mizdraji/Panic-Button/Documentación/Fotos/Prototipo_V1_Frente.jpg

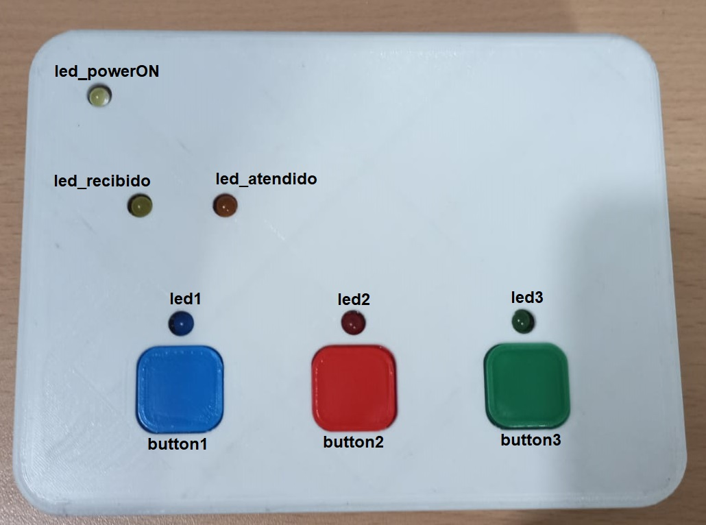
Documentación/Fotos/Prototipo_V1_Frente.jpg
