mizdraji/Panic-Button/Documentación/Fotos/RebotePulsador_4.jpg

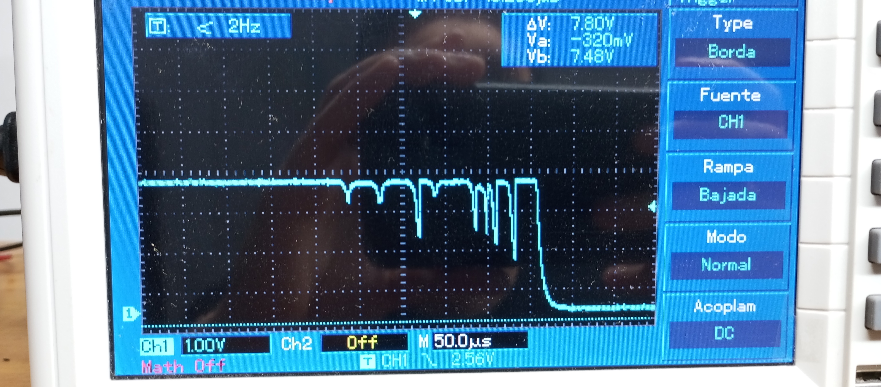
Documentación/Fotos/RebotePulsador_4.jpg
