mizdraji/Panic-Button/Documentación/Fotos/Modelo 3D Boton de panico - Lado A.jpeg

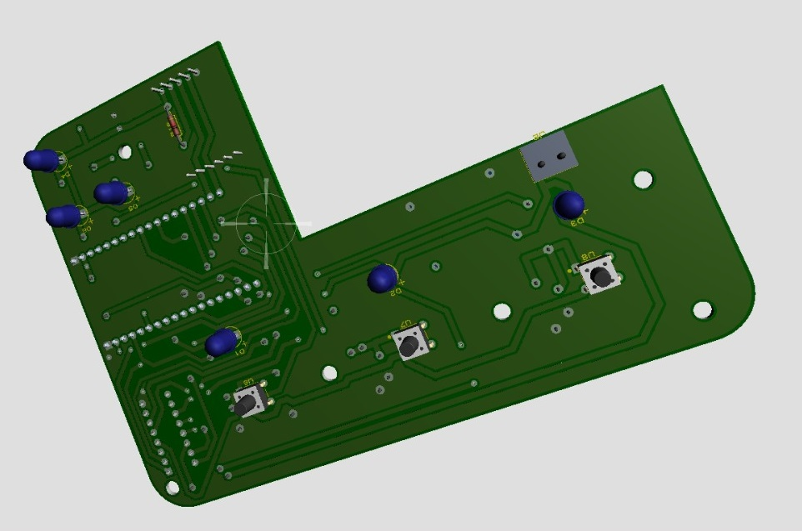
Documentación/Fotos/Modelo 3D Boton de panico - Lado A.jpeg
