mizdraji/Panic-Button/Documentación/Fotos/Modelo 3D Boton de panico - Lado B.jpeg

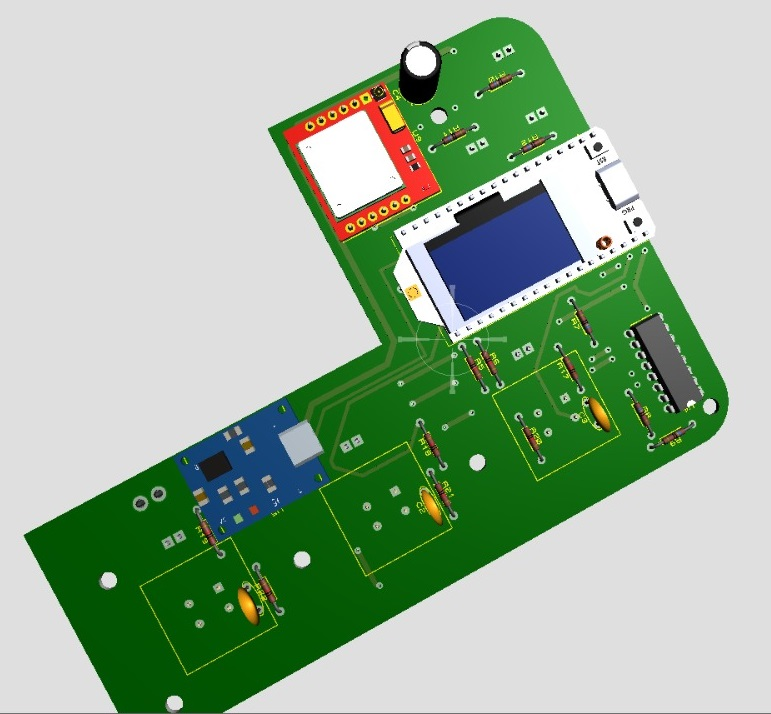
Documentación/Fotos/Modelo 3D Boton de panico - Lado B.jpeg
