mizdraji/Panic-Button/Documentación/Fotos/Prototipo_Protoboard_1.jpg

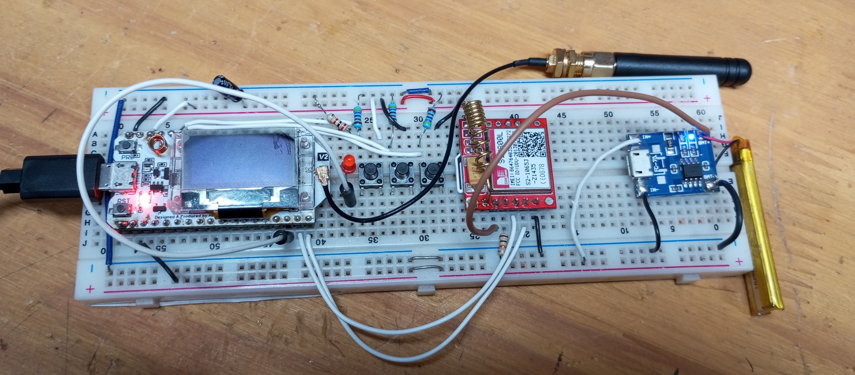
Documentación/Fotos/Prototipo_Protoboard_1.jpg
