mizdraji/Panic-Button/Documentación/Fotos/Prototipo_V1_Frente_con etiqueta.jpg

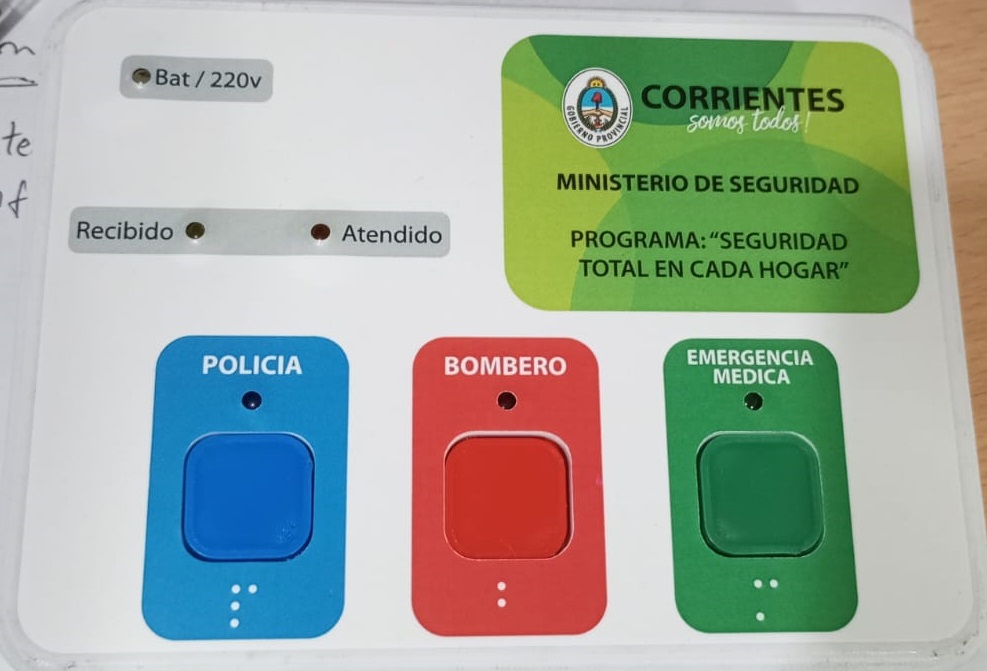
Documentación/Fotos/Prototipo_V1_Frente_con etiqueta.jpg
