mizdraji/Panic-Button/Documentación/Fotos/Prototipo_V1_Placa.jpg

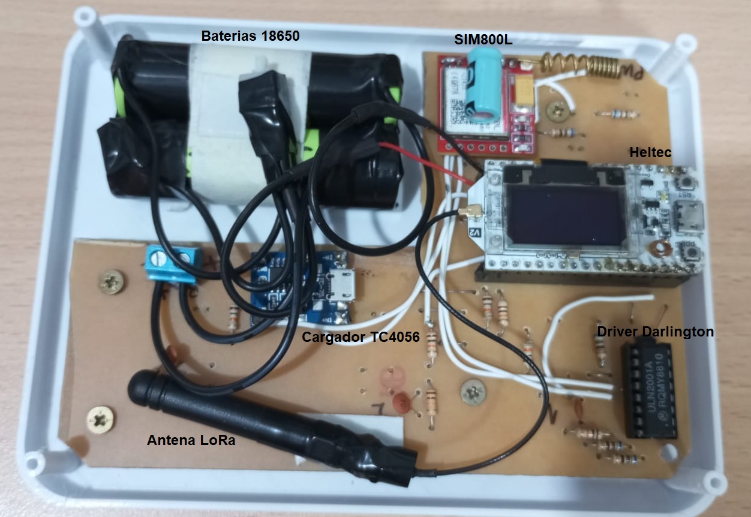
Documentación/Fotos/Prototipo_V1_Placa.jpg
