mizdraji/Panic-Button/Documentación/Fotos/RebotePulsador_1.jpg

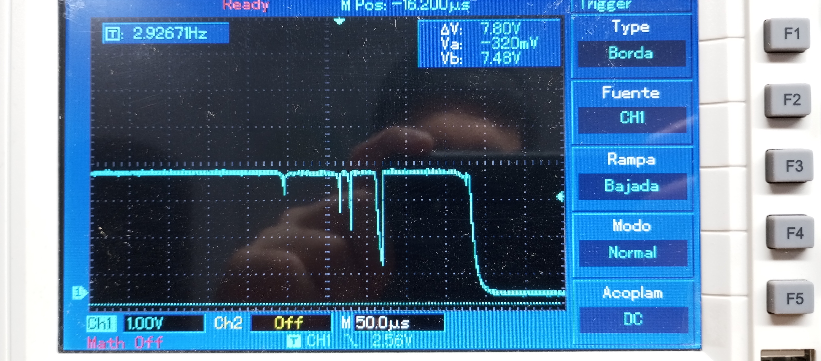
Documentación/Fotos/RebotePulsador_1.jpg
