mizdraji/Panic-Button/Documentación/Fotos/RebotePulsador_2.jpg

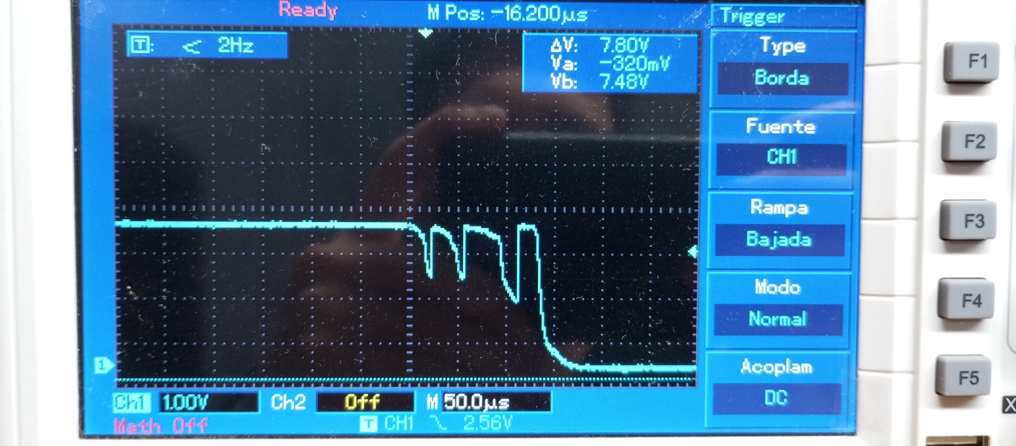
Documentación/Fotos/RebotePulsador_2.jpg
