mizdraji/Panic-Button/Documentación/Fotos/RebotePulsador_3.jpg

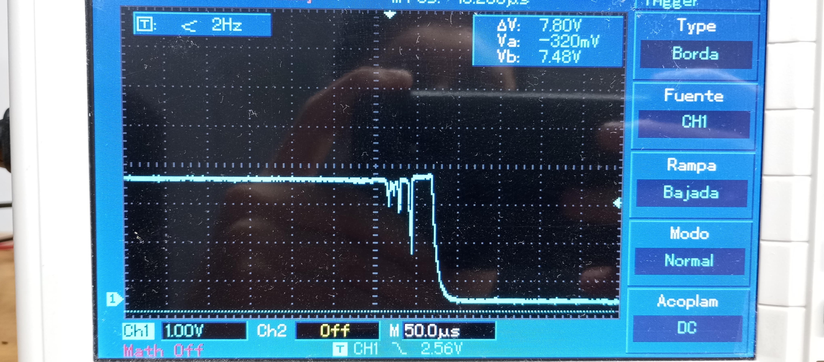
Documentación/Fotos/RebotePulsador_3.jpg
