mizdraji/Panic-Button/Documentación/Schematic/panic button - dimensiones.bmp

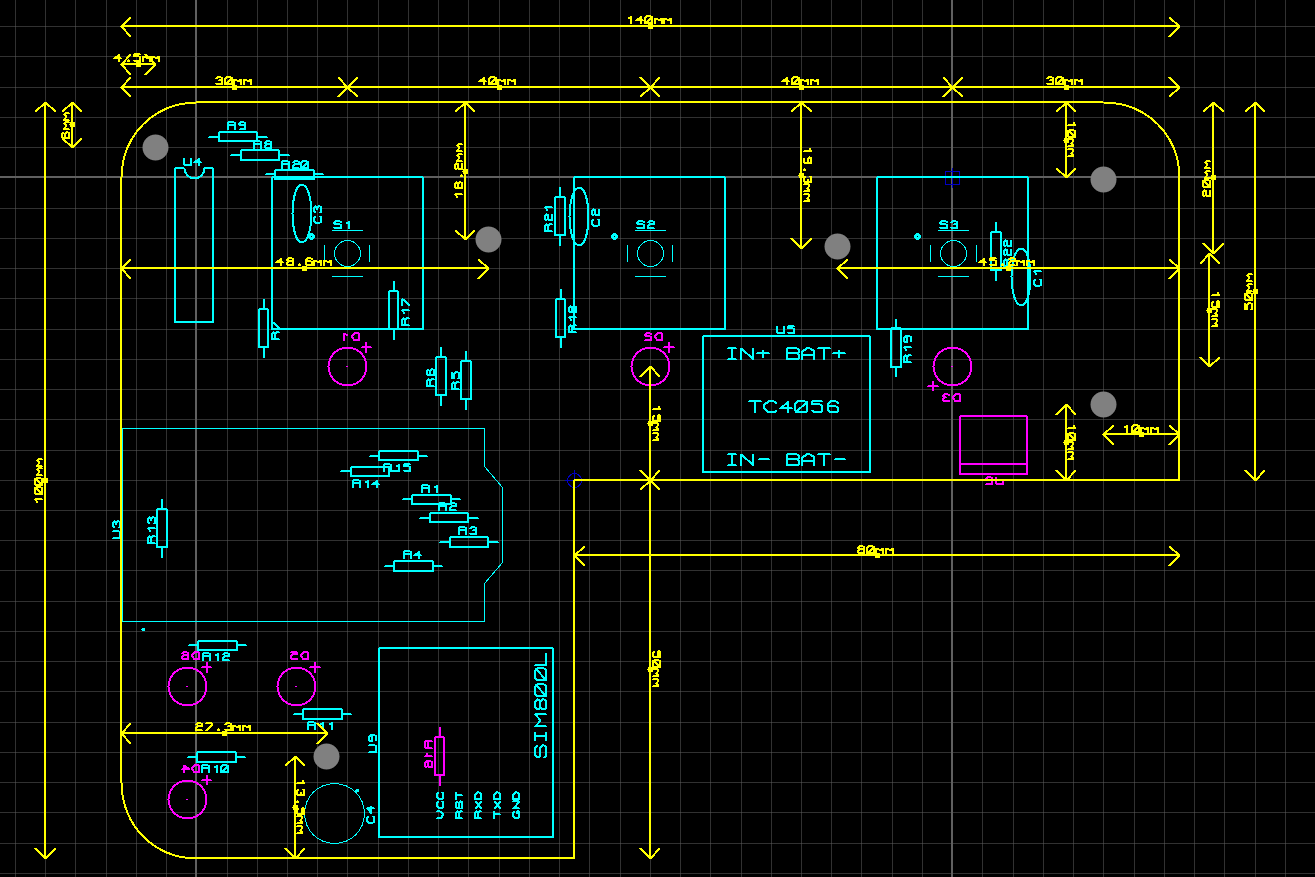
Documentación/Schematic/panic button - dimensiones.bmp
