mizdraji/Panic-Button/Solicitud de cambios para firmware.txt

// Cambios para German:

Al enviar mensajes por SMS o LoRaWAN incluir: (No necesario para la demo):
	* identificador de la aplicación. Ej: "PB" (Panic Button)
	* comando. Ej: "policia".
	* Epoch timestamp. Ej: 1726703523 segundos = 18/09/2024 20:54:08
	* numero_serie del dispositivo. Ej: "PB00001" (Puede ser generado por el servidor y enviado en la respuesta del proceso de activación de LoRaWAN).
	* versión del firmware.
	* versión del hardware.

	Ejemplo de mensaje: "PB, policia, 1726703523, PB00001, fv:1.0.0, hv:1.0.0".

Funcionamiento de idempotencia:
	Epoch timestamp se utilizará como clave de idempotencia. Esta clave asegura el procesamiento único de peticiones. 
	Al recibir una petición del mismo dispositivo, con el mismo comando e igual clave de idempotencia se responderá inmediatamente sin procesar
	nuevamente la alerta.

Respuesta:
	* identificador de la aplicación. Ej: "PB" (Panic Button)
	* comando. Ej: "policiarcv".
	* Epoch timestamp. Ej: 1726703523 (idempotencia)
	* Epoch timestamp actual (para sincronización de relojes)
	* numero_serie del dispositivo. Ej: "PB00001" (Puede ser generado por el servidor y enviado en la respuesta del proceso de activación de LoRaWAN).
	
	Ejemplo de mensaje: "PB, policiarcv, 1726703523, 1726703534, PB00001".
