mizdraji/Panic-Button/Documentación/Schematic/Boton de panico - Heltek - Schematic.PDF

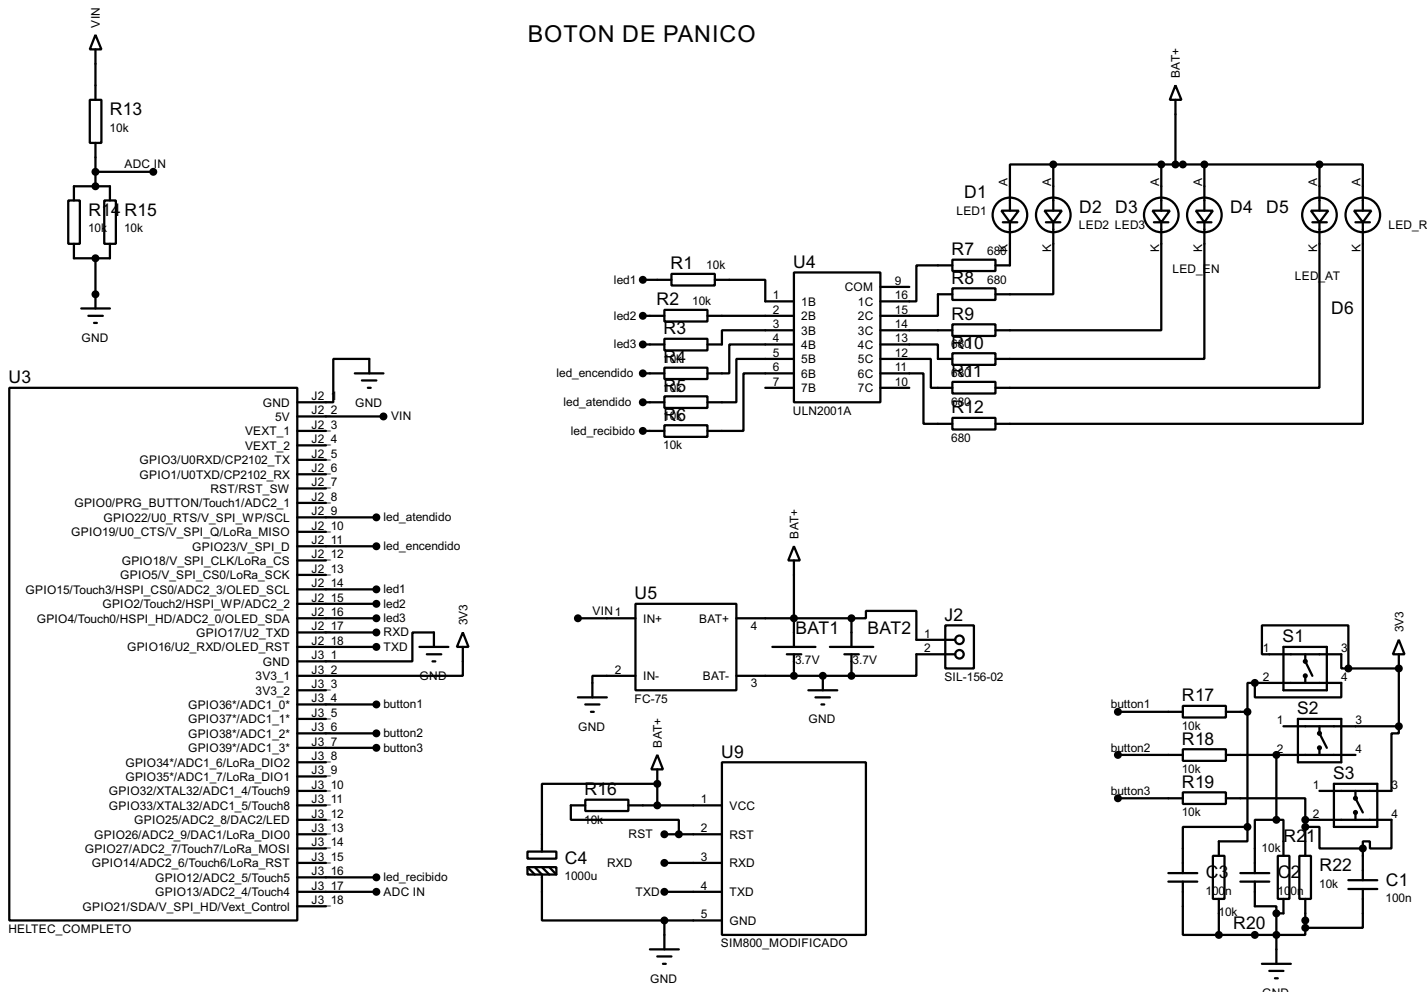
[picture p12: page 1]

4 | 13
5 | 12
6 | 11
7 | 10

J2_18 J3_1 | TXD

J3_3 GND J3_2
