mizdraji/Panic-Button/Documentación/Schematic/Boton de panico - Heltek - Dimensiones.PDF

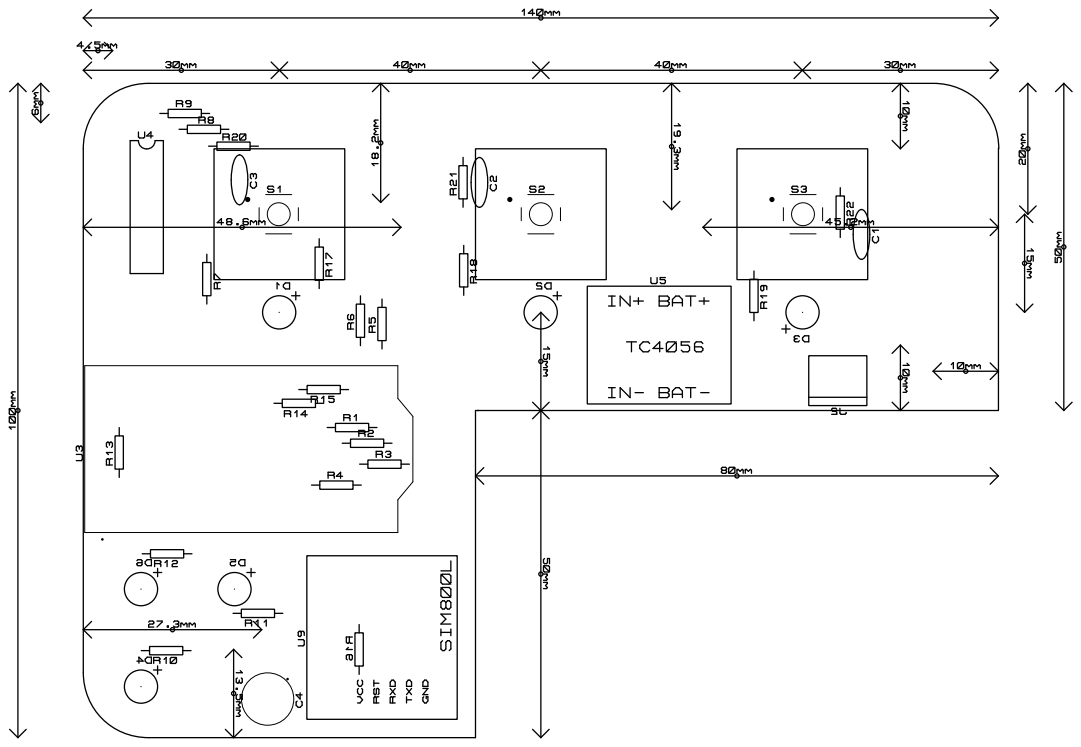
[picture p13: page 1]
