mizdraji/Panic-Button/Documentación/Schematic/BOTON PANICO PCB.pdf

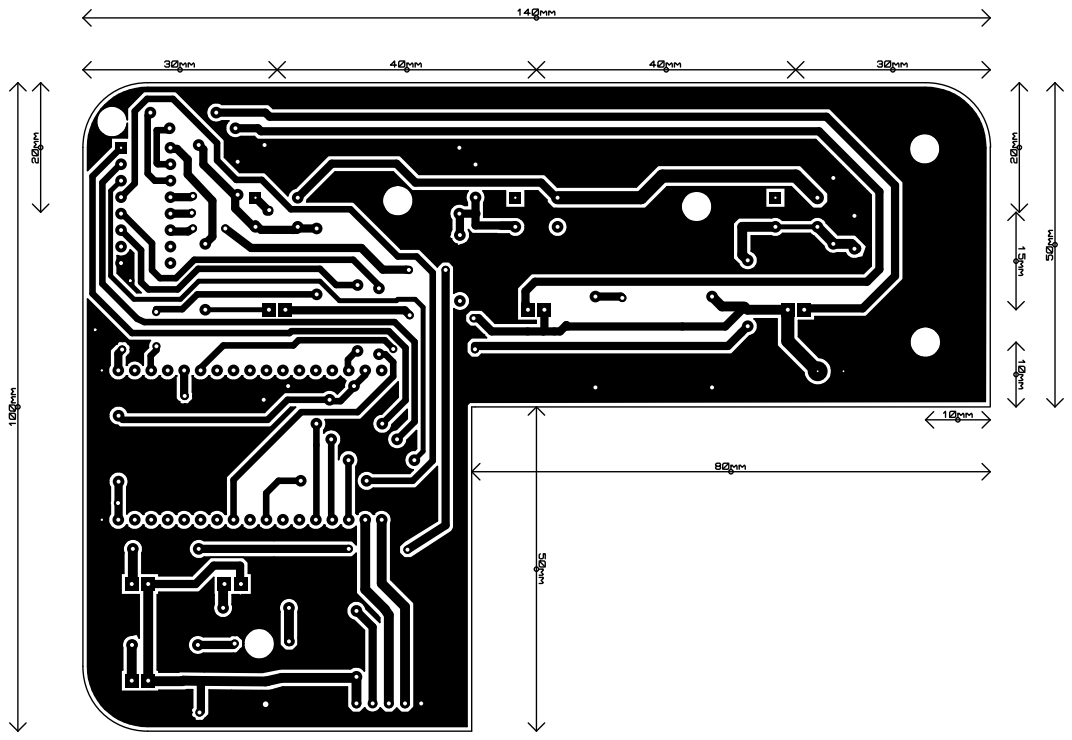
[picture p14: page 1]
