mizdraji/Panic-Button/Documentación/Schematic/Boton de panico - Heltek - PCB.PDF

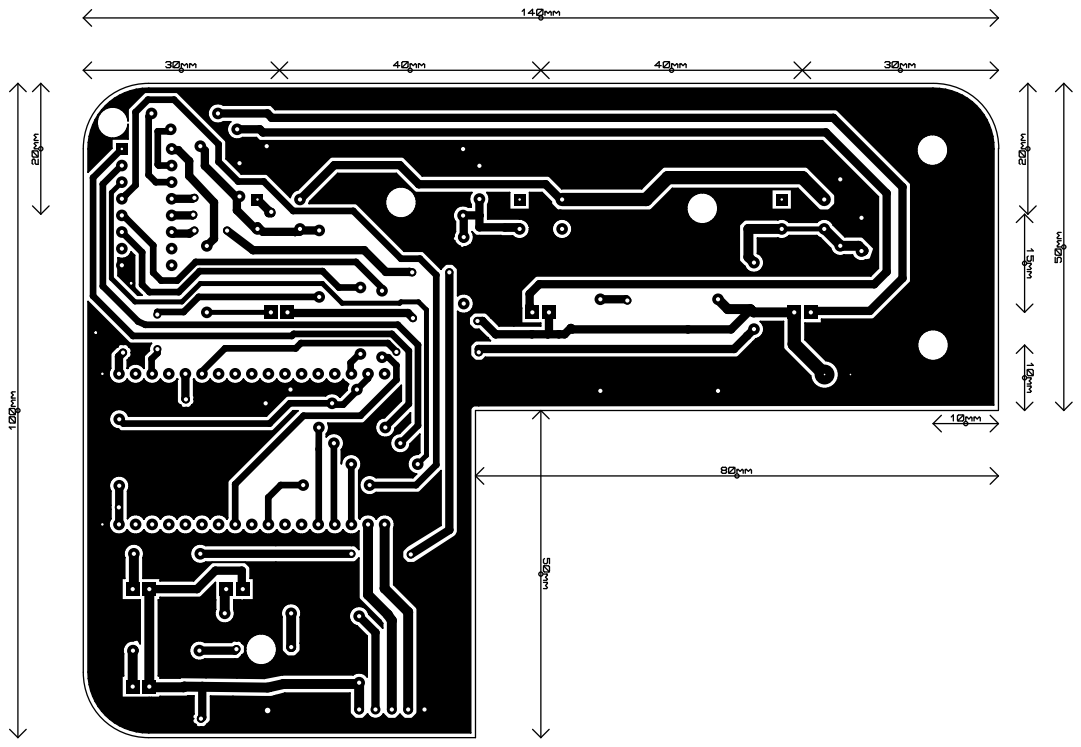
[picture p15: page 1]
