mizdraji/Panic-Button/Documentación/Prototipo web.pdf

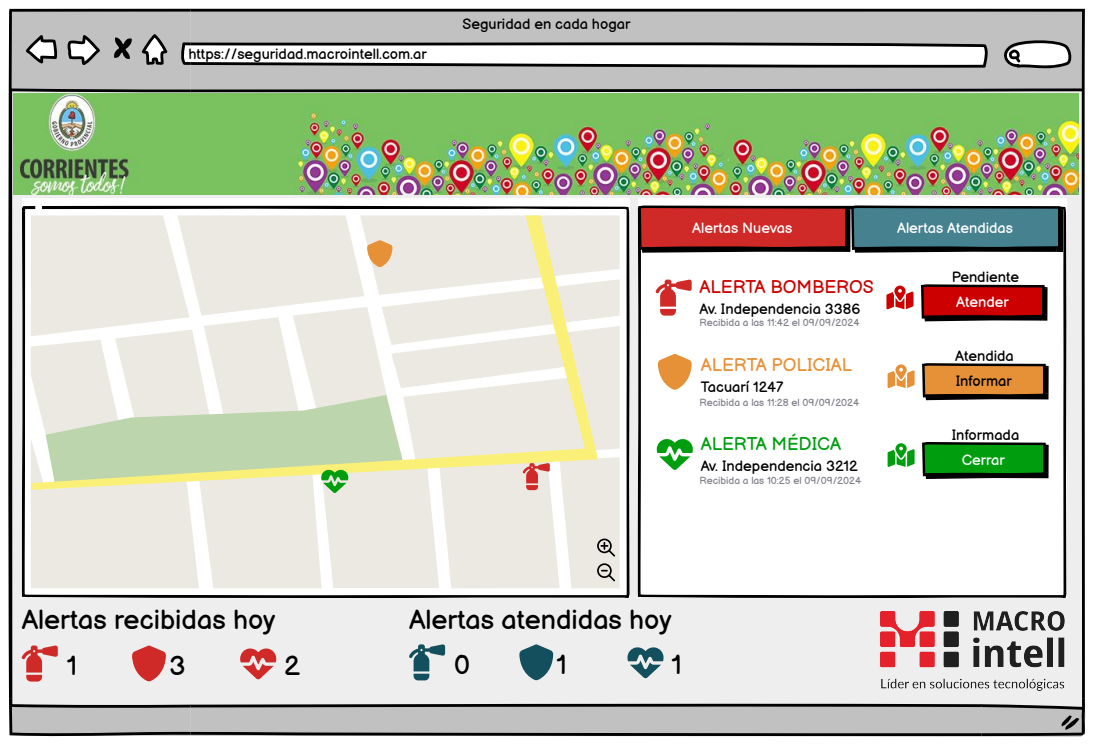
[picture p16: page 1]
Atender; Alertas Nuevas; Alertas Atendidas; Informar; Cerrar; Pendiente; Atendida; Informada; Alertas recibidas hoy; Alertas atendidas hoy

Seguridad en cada hogar

https://seguridad.macrointell.com.ar

ALERTA BOMBEROS
Av. Independencia 3386
Recibida a las 11:42 el 09/09/2024
ALERTA POLICIAL
Tacuarí 1247
Recibida a las 11:28 el 09/09/2024
ALERTA MÉDICA
Av. Independencia 3212
Recibida a las 10:25 el 09/09/2024

# NUEVA ALERTA

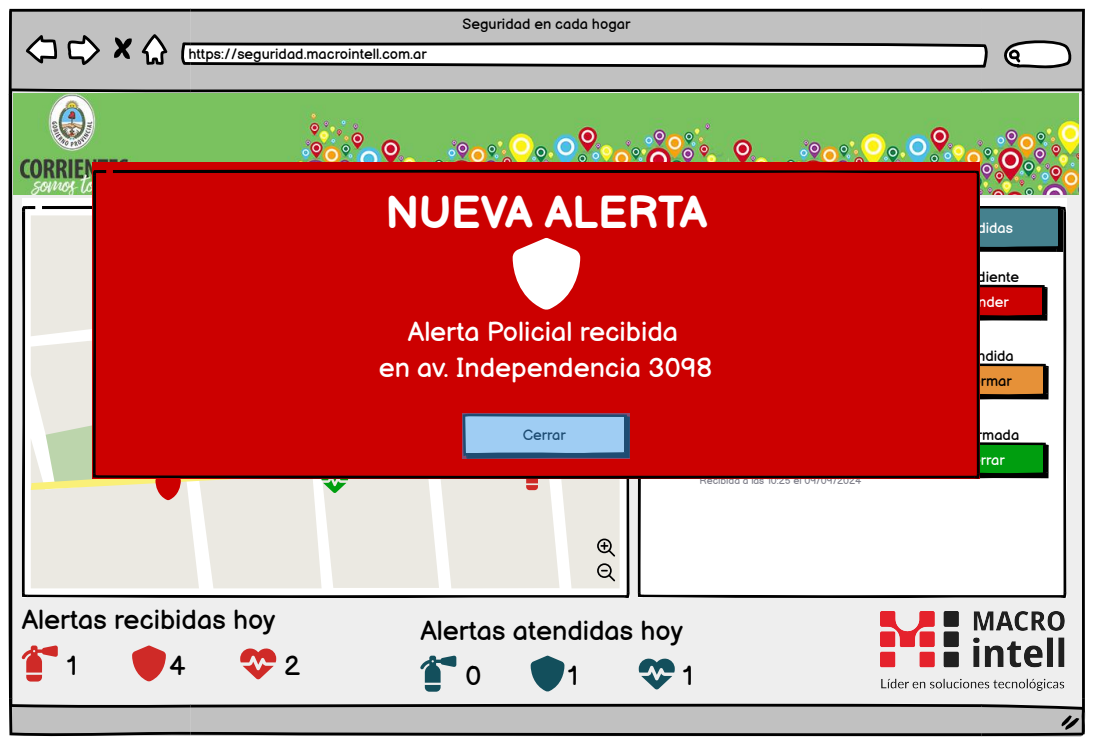
[picture p17: page 2]
Atender; Alertas Nuevas; Alertas Atendidas; Informar; Cerrar; Pendiente; Atendida; Informada

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

Alerta Policial recibida
en av. Independencia 3098

Alertas recibidas hoy

Alertas atendidas hoy

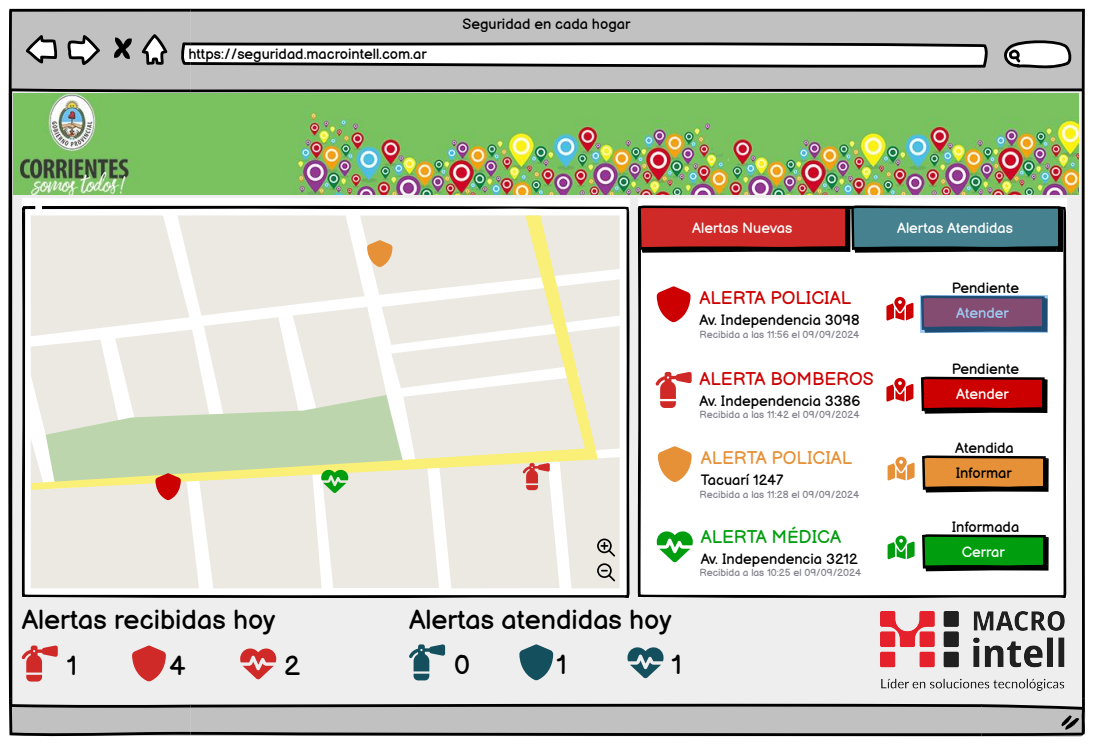
[picture p18: page 3]
Atender; Alertas Nuevas; Alertas Atendidas; Informar; Cerrar; Pendiente; Atendida; Informada

ALERTA POLICIAL
Av. Independencia 3098
Recibida a las 11:56 el 09/09/2024
ALERTA BOMBEROS
Av. Independencia 3386
Recibida a las 11:42 el 09/09/2024
Tacuarí 1247
Recibida a las 11:28 el 09/09/2024
ALERTA MÉDICA
Av. Independencia 3212
Recibida a las 10:25 el 09/09/2024

Alertas recibidas hoy

Alertas atendidas hoy

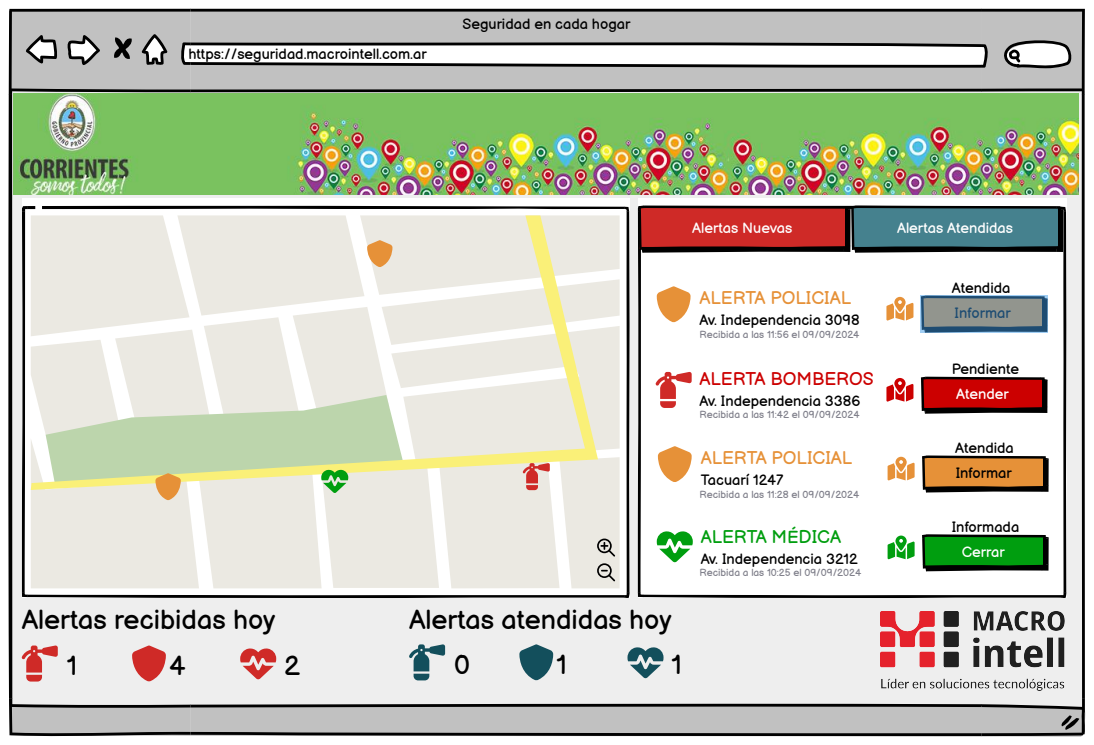
[picture p19: page 4]
Informar; Atender; Alertas Nuevas; Alertas Atendidas; Cerrar; Atendida; Pendiente; Informada

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

Alertas recibidas hoy

Alertas atendidas hoy

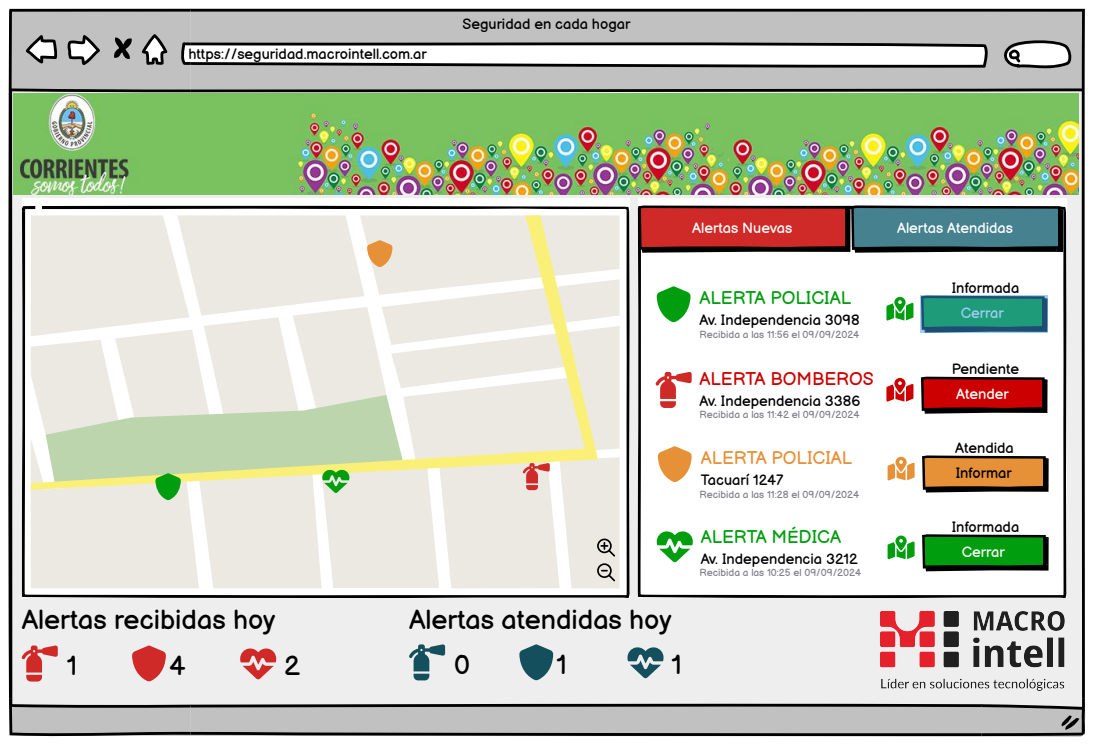
[picture p20: page 5]
Cerrar; Atender; Alertas Nuevas; Alertas Atendidas; Informar; Informada; Pendiente; Atendida

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

Alertas recibidas hoy

Alertas atendidas hoy

# Cerrar Alerta

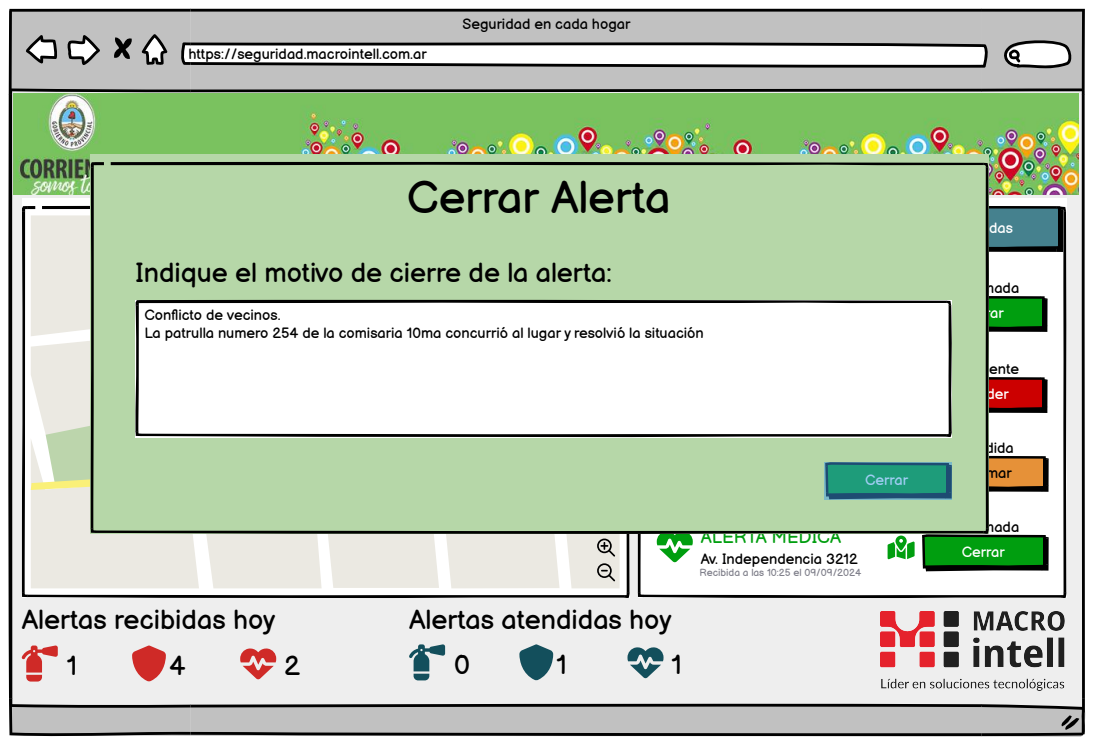
[picture p21: page 6]
Cerrar; Atender; Alertas Nuevas; Alertas Atendidas; Informar; Informada; Pendiente; Atendida

Indique el motivo de cierre de la alerta:

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

Conflicto de vecinos.
La patrulla numero 254 de la comisaria 10ma concurrió al lugar y resolvió la situación

Alertas recibidas hoy

Alertas atendidas hoy

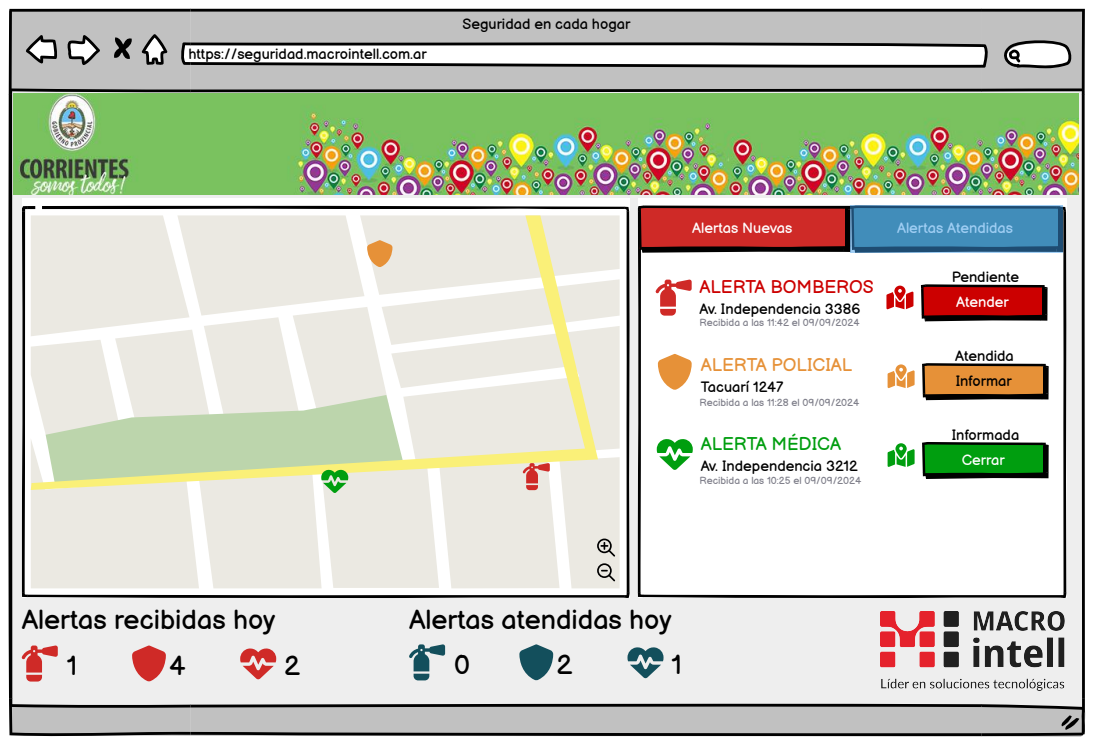
[picture p22: page 7]
Atender; Alertas Nuevas; Alertas Atendidas; Informar; Cerrar; Pendiente; Atendida; Informada

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

Alertas recibidas hoy

Alertas atendidas hoy

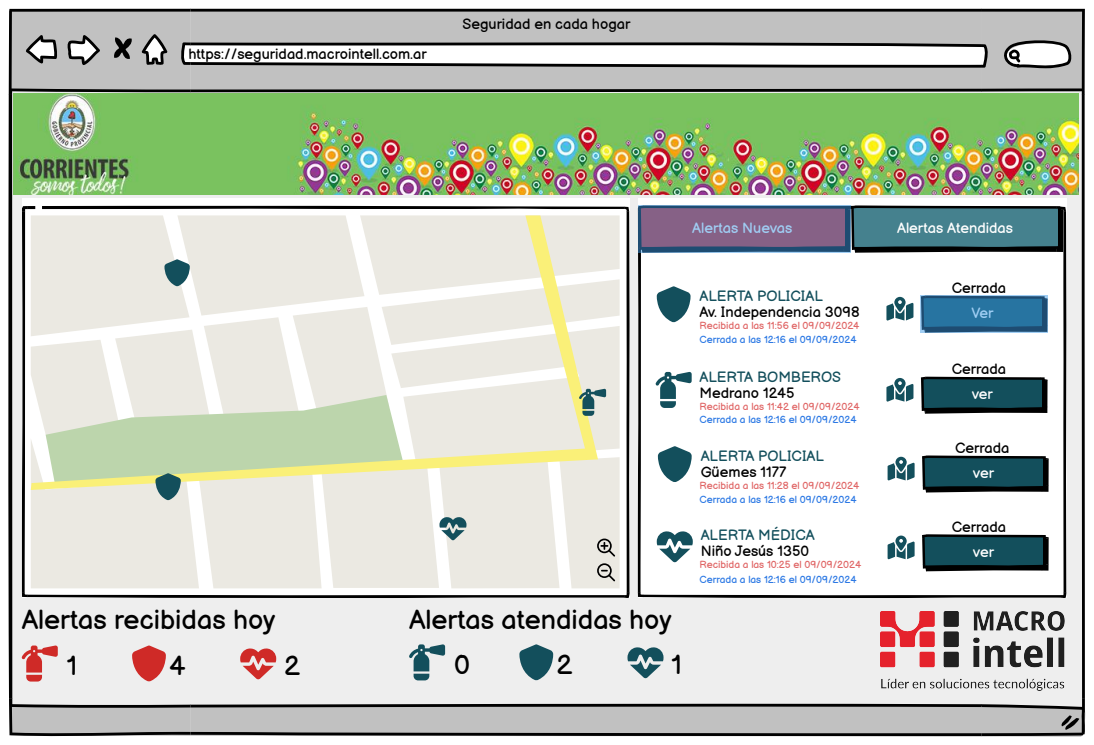
[picture p23: page 8]
Ver; ver; Alertas Nuevas; Alertas Atendidas; Cerrada

ALERTA POLICIAL
Av. Independencia 3098
Recibida a las 11:56 el 09/09/2024
Cerrada a las 12:16 el 09/09/2024
ALERTA BOMBEROS
Medrano 1245
Recibida a las 11:42 el 09/09/2024
Güemes 1177
Recibida a las 11:28 el 09/09/2024
ALERTA MÉDICA
Niño Jesús 1350
Recibida a las 10:25 el 09/09/2024

Alertas recibidas hoy

Alertas atendidas hoy

# Alerta Cerrada

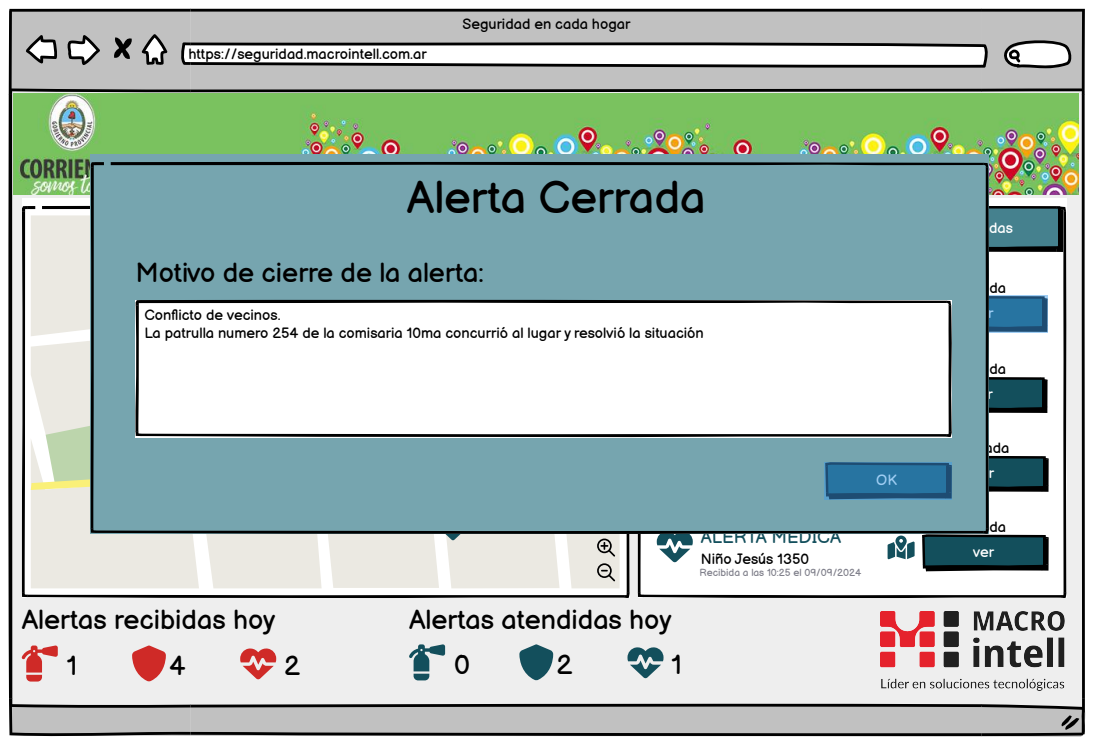
[picture p24: page 9]
Ver; ver; Alertas Nuevas; Alertas Atendidas; Cerrada

Motivo de cierre de la alerta:

ALERTA POLICIAL
Av. Independencia 3098
Recibida a las 11:56 el 09/09/2024
ALERTA BOMBEROS
Medrano 1245
Recibida a las 11:42 el 09/09/2024
Güemes 1177
Recibida a las 11:28 el 09/09/2024
ALERTA MÉDICA
Niño Jesús 1350
Recibida a las 10:25 el 09/09/2024

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

Alertas recibidas hoy

Alertas atendidas hoy
