mizdraji/Panic-Button/Documentación/Prototipo web2.pdf

# Seguridad en Cada Hogar

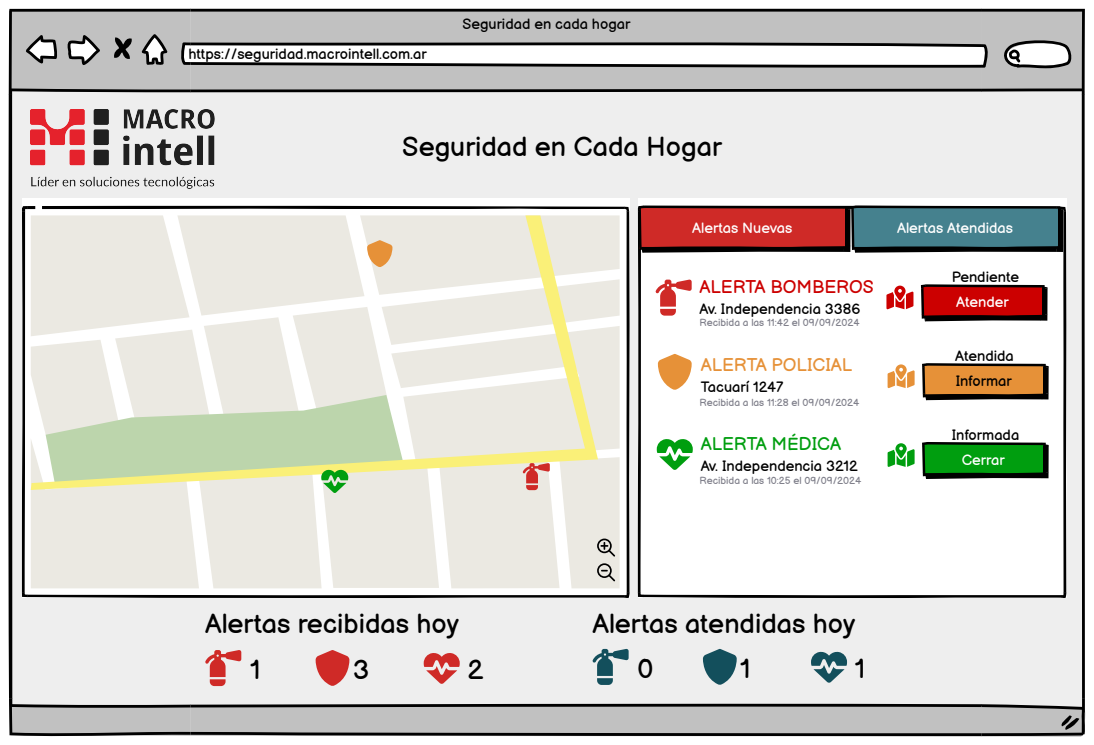
[picture p25: page 1]
Atender; Alertas Nuevas; Alertas Atendidas; Informar; Cerrar; Pendiente; Atendida; Informada; Alertas recibidas hoy; Alertas atendidas hoy

Seguridad en cada hogar

https://seguridad.macrointell.com.ar

ALERTA BOMBEROS
Av. Independencia 3386
Recibida a las 11:42 el 09/09/2024
ALERTA POLICIAL
Tacuarí 1247
Recibida a las 11:28 el 09/09/2024
ALERTA MÉDICA
Av. Independencia 3212
Recibida a las 10:25 el 09/09/2024

# NUEVA ALERTA

# Seguridad en Cada Hogar

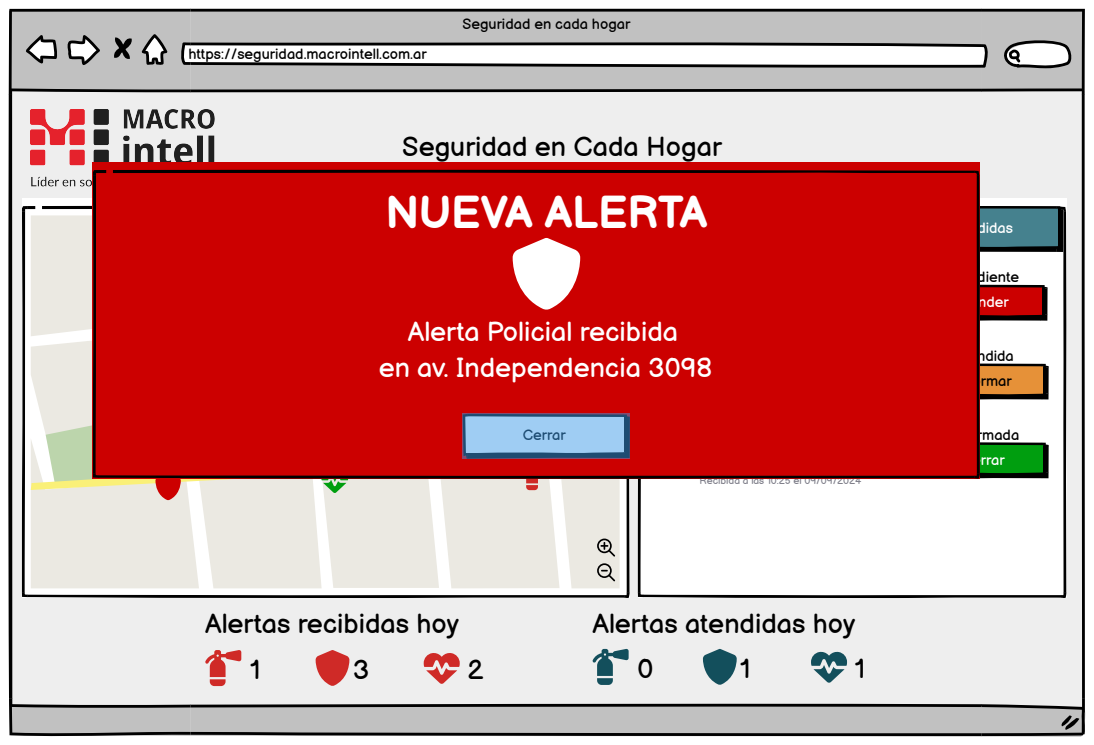
[picture p26: page 2]
Atender; Alertas Nuevas; Alertas Atendidas; Informar; Cerrar; Pendiente; Atendida; Informada; Alertas recibidas hoy; Alertas atendidas hoy

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

Alerta Policial recibida
en av. Independencia 3098

# Seguridad en Cada Hogar

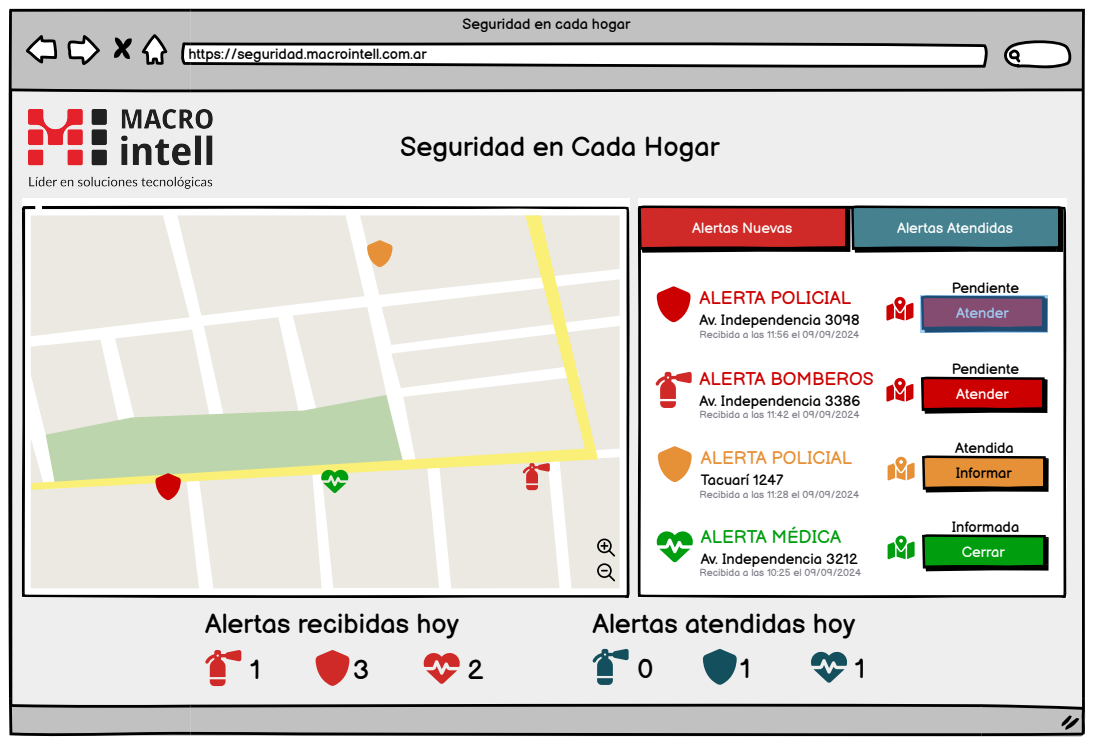
[picture p27: page 3]
Atender; Alertas Nuevas; Alertas Atendidas; Informar; Cerrar; Pendiente; Atendida; Informada; Alertas recibidas hoy; Alertas atendidas hoy

ALERTA POLICIAL
Av. Independencia 3098
Recibida a las 11:56 el 09/09/2024
ALERTA BOMBEROS
Av. Independencia 3386
Recibida a las 11:42 el 09/09/2024
Tacuarí 1247
Recibida a las 11:28 el 09/09/2024
ALERTA MÉDICA
Av. Independencia 3212
Recibida a las 10:25 el 09/09/2024

# Seguridad en Cada Hogar

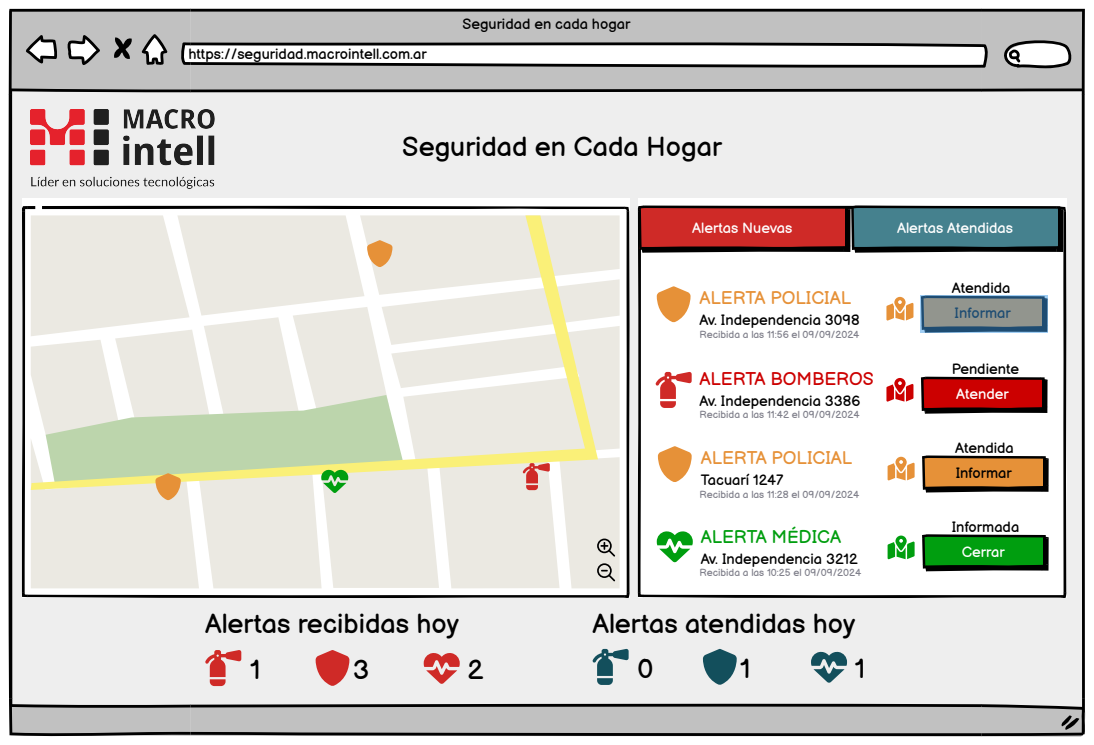
[picture p28: page 4]
Informar; Atender; Alertas Nuevas; Alertas Atendidas; Cerrar; Atendida; Pendiente; Informada; Alertas recibidas hoy; Alertas atendidas hoy

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

# Seguridad en Cada Hogar

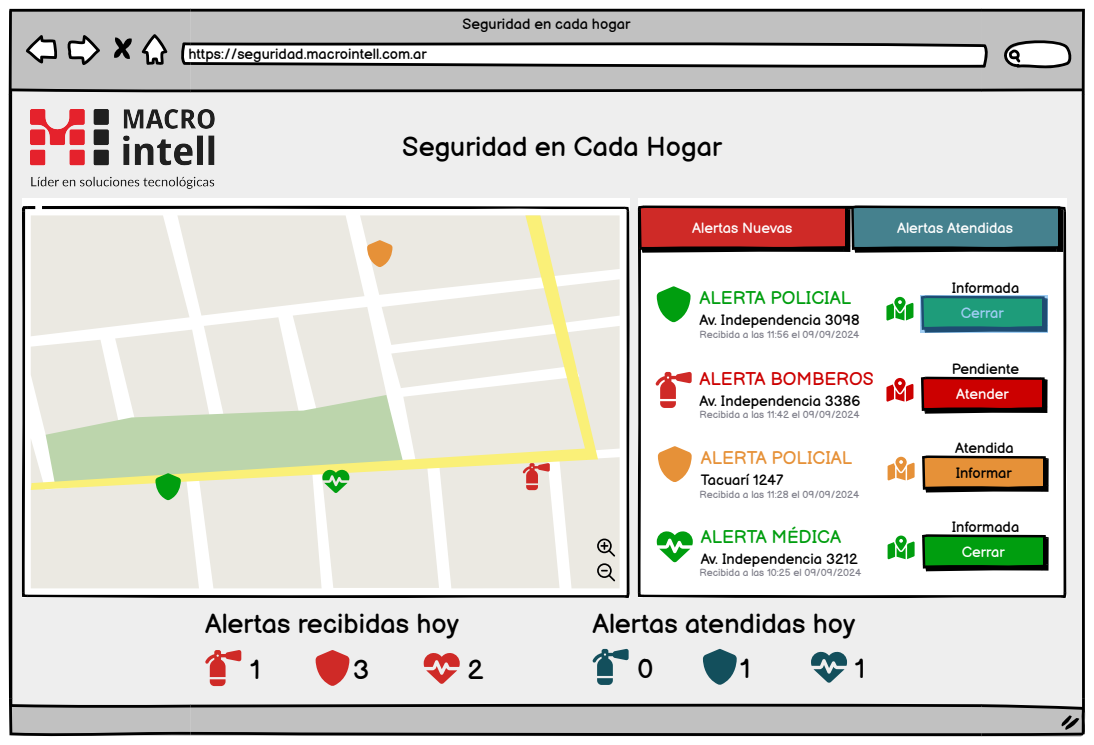
[picture p29: page 5]
Cerrar; Atender; Alertas Nuevas; Alertas Atendidas; Informar; Informada; Pendiente; Atendida; Alertas recibidas hoy; Alertas atendidas hoy

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

# Seguridad en Cada Hogar

# Cerrar Alerta

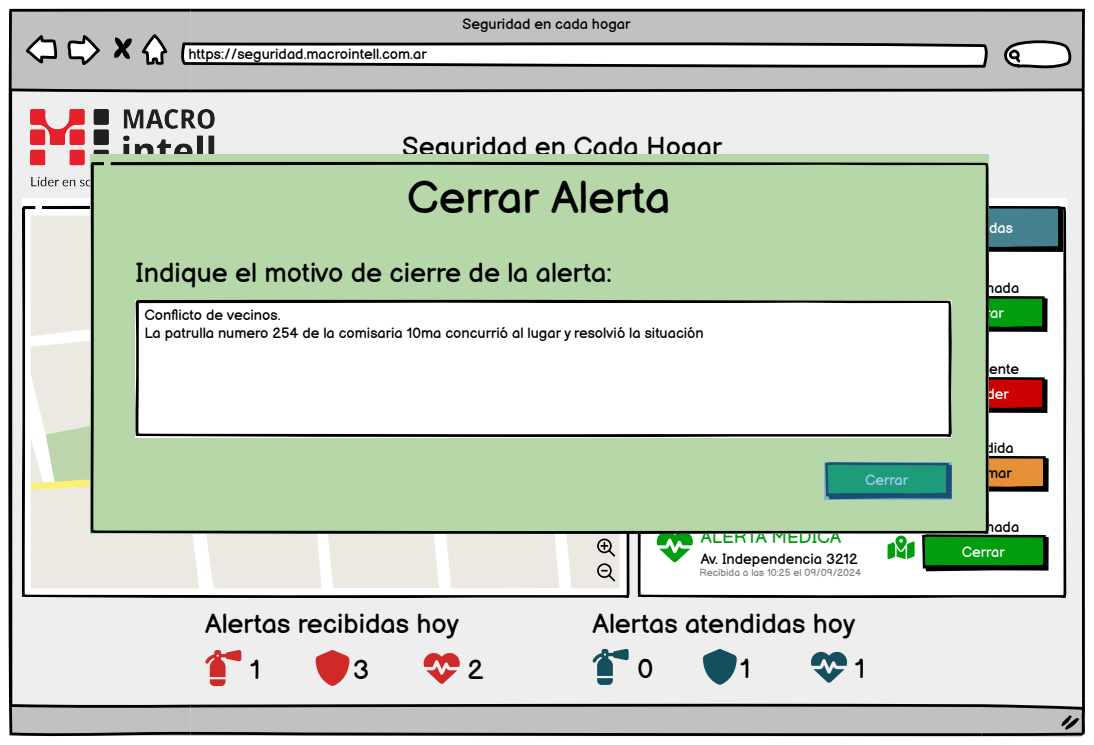
[picture p30: page 6]
Cerrar; Atender; Alertas Nuevas; Alertas Atendidas; Informar; Informada; Pendiente; Atendida; Alertas recibidas hoy; Alertas atendidas hoy

Indique el motivo de cierre de la alerta:

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

Conflicto de vecinos.
La patrulla numero 254 de la comisaria 10ma concurrió al lugar y resolvió la situación

# Seguridad en Cada Hogar

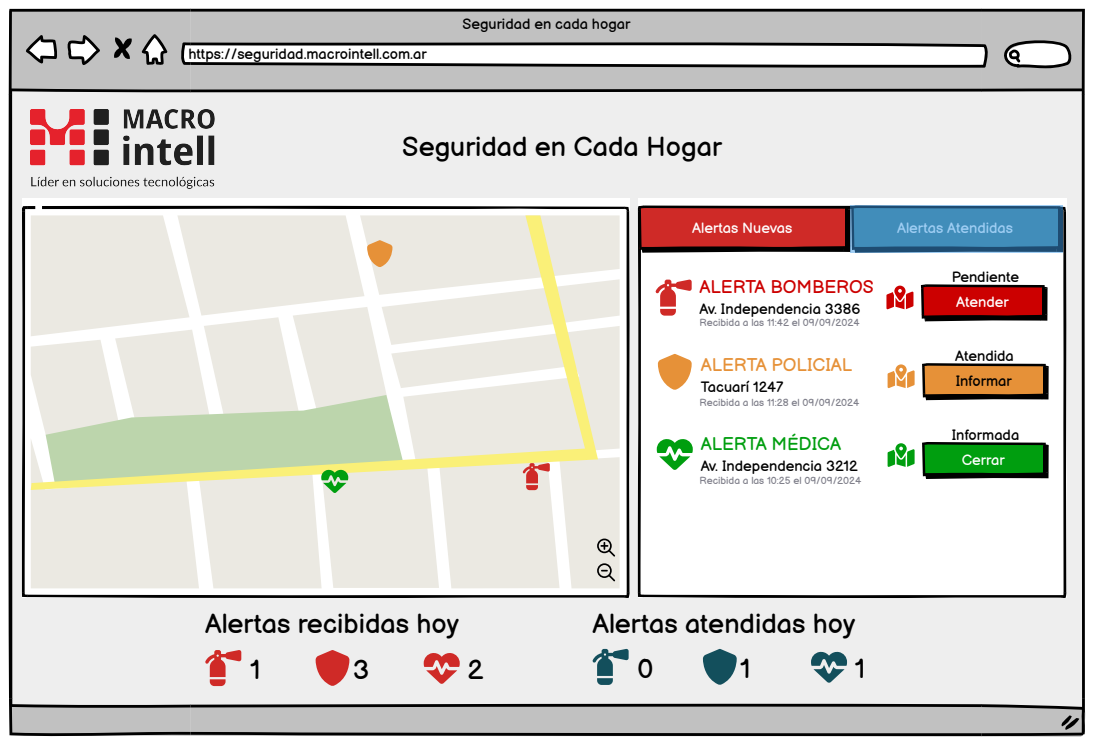
[picture p31: page 7]
Atender; Alertas Nuevas; Alertas Atendidas; Informar; Cerrar; Pendiente; Atendida; Informada; Alertas recibidas hoy; Alertas atendidas hoy

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

# Seguridad en Cada Hogar

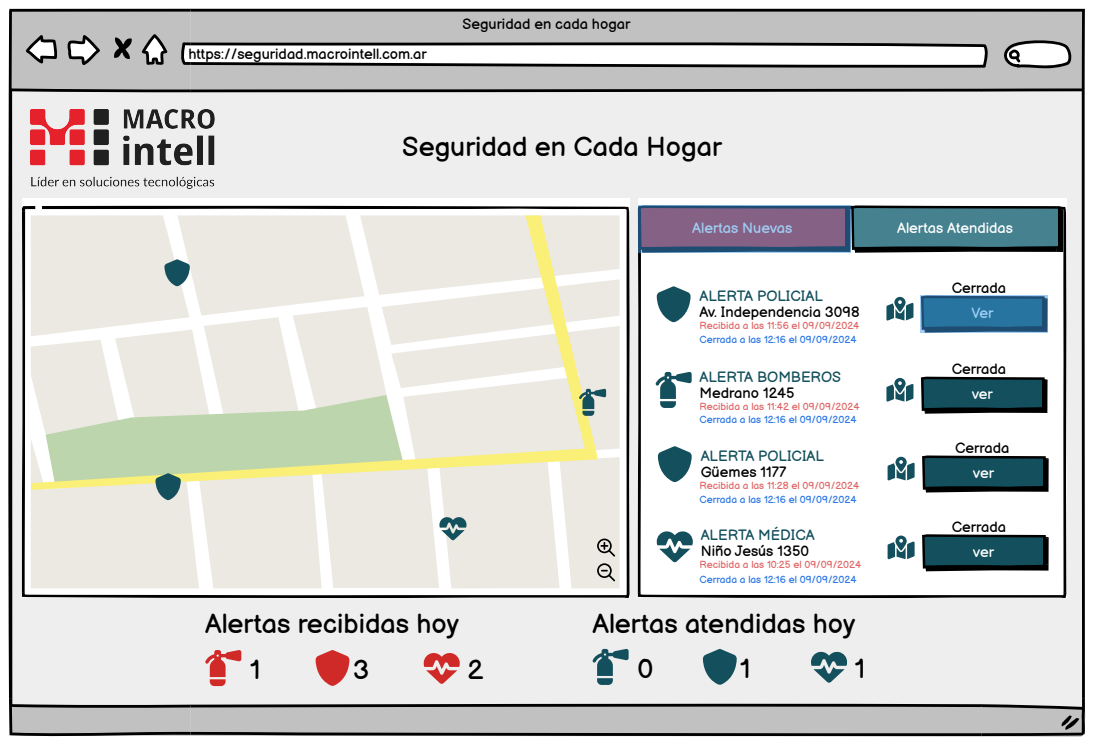
[picture p32: page 8]
Ver; ver; Alertas Nuevas; Alertas Atendidas; Cerrada; Alertas recibidas hoy; Alertas atendidas hoy

ALERTA POLICIAL
Av. Independencia 3098
Recibida a las 11:56 el 09/09/2024
Cerrada a las 12:16 el 09/09/2024
ALERTA BOMBEROS
Medrano 1245
Recibida a las 11:42 el 09/09/2024
Güemes 1177
Recibida a las 11:28 el 09/09/2024
ALERTA MÉDICA
Niño Jesús 1350
Recibida a las 10:25 el 09/09/2024

# Seguridad en Cada Hogar

# Alerta Cerrada

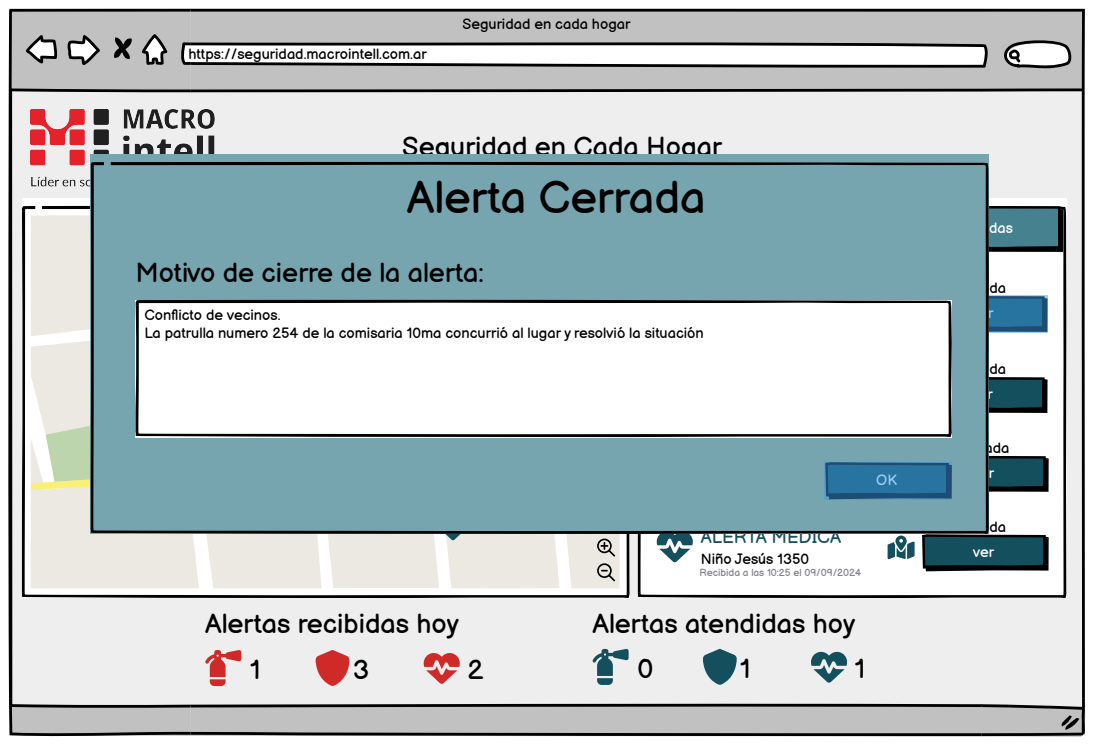
[picture p33: page 9]
Ver; ver; Alertas Nuevas; Alertas Atendidas; Cerrada; Alertas recibidas hoy; Alertas atendidas hoy

Motivo de cierre de la alerta:

ALERTA POLICIAL
Av. Independencia 3098
Recibida a las 11:56 el 09/09/2024
ALERTA BOMBEROS
Medrano 1245
Recibida a las 11:42 el 09/09/2024
Güemes 1177
Recibida a las 11:28 el 09/09/2024
ALERTA MÉDICA
Niño Jesús 1350
Recibida a las 10:25 el 09/09/2024

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
