mizdraji/Panic-Button/(list of files, drawings)

Other design files:
Documentación/Schematic/Boton de panico - Heltek - Schematic.pdsprj
