mizdraji/Panic-Button/Sketchup/Panic_Button/ABPCredentials.h

//ABP Credentials para comunicación LoRa

//PB00001
#define devID 00001
#define devAddr "0149cf9b"
#define nwkSKey "d8e5a8e01bddfaf48e059992119be745"
#define appSKey "3f19e1ef0da5286e178c5b84fc9e23ae"

//PB00001
// #define devID 00001
// const char *devAddr = "0149cf9b";
// const char *nwkSKey = "d8e5a8e01bddfaf48e059992119be745";
// const char *appSKey = "3f19e1ef0da5286e178c5b84fc9e23ae";
