mizdraji/Panic-Button/(commit log)

2024-08-29 cambios nombres
    se cambian nombre de archivos y se borra carpeta
2024-08-29 Update Prueba_SIM800_Heltec.ino
    se saca reset por soft para colocar un pull up por hardware-
    Se corrige enviar mensaje al apretar el boton
    [Prueba_SIM800_Heltec.ino]
2024-09-03 Version 1.0 panic button
    Se empieza a armar la estructura del firmware V1.0
2024-09-03 V1.0
    primera parte funcional, se envia un comando cada X tiempo, falta agregar tareas para pulsadores y leds
2024-09-03 blink de baja frecuencia
    Se agrega blink de baja frecuencia al programador de tareas para mostrar que el dispositivo esta funcionando
2024-09-04 dual core pruebas
    se agregan pruebas para usar dual core en esp32
2024-09-04 V1.1
    descripción de versiones
2024-09-04 libreria lora beelan
    se modifica la librería beelan comentando algunas funciones
2024-09-05 1.2
    se cambia config pines por pinout y se crea funcion config_pines.
    Se crea Hardware.h y Hardware.ino
    Se crea funcion pdr para prueba de red pero aun no esta funcional.
2024-09-06 Update Prueba_SIM800_Heltec.ino
    se actualiza pruebasim800 para enviar 3 mensajes con 3 pulsadores y para recibir mensajes.
2024-09-06 Create Prueba_SIM800_BufferMasGrande.ino
    prueba sim800 se crea un buffer que se va actualizando para recibir mensajes mas grandes
2024-09-09 Prueba_task_scheduler_interrupt
    Se agrega Prueba_task_scheduler_interrupt.
    Se ejecuta una tarea luego de que se ejecuto una interrupción.
    Se agrega prioridad a la tarea con interrupción
2024-09-09 V1.3
    Detalle de versiones:
    * V1.3:
    * Se configuran los 3 pulsadores como tareas que se activan a travez de interrupciones. (pendiente mejorar rebote)
    * Se crea el objeto Scheduler interrupt para establecer como alta prioridad
    * Se cambian los nombres de las tareas por t1-t7
    * Se crean las tareas t5, t6 y t7 para interrupciones
    * Se crea estructura de mensajes para continuar con SMS en proxima version.
2024-09-10 update 1.4
    * Se agregan funciones Serialcom y ReceiveMode en Hardware.ino para enviar/recibir SMS
2024-09-10 Update Panic_Button.ino
    Se envia uncero al iniciar el setup por LORA para establecer la conexión.
    Se organiza setup
2024-09-10 update
    se crea struct con mensajes predeterminados para enviar
2024-09-10 Update Panic_Button.ino
    se corrige el remitente, va con numero.remitente
    [Panic_Button.ino]
2024-09-10 Create Prueba_SIM800_Heltec_Consulta_Redes_disponibles.ino
    Se crea prueba de consulta de redes disponibles a través de comando AT
2024-09-10 Fotos_Documentacion
    Se agregan algunas fotos a la documentación y se actualiza VERSION.md
2024-09-11 Schematic
    Se carga esquemático de la placa + PDF
    [Boton de panico - Heltek - Schematic.pdsprj]
2024-09-11 1
    1
    [Boton de panico - Heltek - Schematic [20240911, 13-09-05].pdsprj, Boton de panico - Heltek - Schematic.pdsprj]
2024-09-11 update gitignore
    gitignore
    [Boton de panico - Heltek - Schematic [20240911, 13-09-05].pdsprj]
2024-09-11 Update Boton de panico - Heltek - Schematic.pdsprj
    [Boton de panico - Heltek - Schematic.pdsprj]
2024-09-12 UPDATE PINOUT
    se agregan leds faltantes en pinout
2024-09-12 update 1.5v
    * V1.5
    * * * V1.5:
    * * Se agregan los pinout faltantes de leds.
    * * Se agrega mensajes recibidos de confirmación. Pendiente agregar todos los mensajes recibidos sms, aun falta todo LORA.
    * * Se agregan funciones prender y apagar led para trabajar con tareas programadas.
    * * Se prende el led_recibido cuando se recibe una respuesta correcta durante 50 segundos.
    * * Se agrega capacitor de 1000uF 10V entre VCC y GND del modulo GSM para evitar errores de lectura y reseteos del ESP32
    por baja tensión que genera el modulo SIM800.
    [Panic_Button.ino, Task.h, Task.ino]
2024-09-12 update1.6
    mensajes de recepcion para lora
2024-09-13 lorasend
    se corrigo envio de paquetes lora
    [Task.ino, configuracion.h]
2024-09-13 update debug
    se agregan algunos debug
    se borran unas variables de statebutton que estaban repetidas
2024-09-13 update
    * Se cambia GPIO37 de button1 por GPIO36, el 37 generaba problemas.
    * Se agregan tareas para apagar leds1,2 y 3.
    * Pendiente corregir BUG detectado: al presionar un boton para enviar un mensaje, envia 1 mensaje SMS pero se reciben 2 o 3 de lora (PASA EN EL GW DE LABORATORIO).
    * Pendiente actualizar esquemático.
    * Se mueven funciones de interrupcion a panic_button.ino
    * Pendiente configurar tiempos de encendido y apagado de leds
    [LoraTec.h, Panic_Button.ino, Task.h, Task.ino, pinout.h]
2024-09-18 update schematic
    [Boton de panico - Heltek - Schematic.pdsprj]
2024-09-20 new branch
    se crea branch para empezar a trabajar con la version 1.7
2024-09-20 update 1.7
    * Se cambian algunas variables por define para mejorar rendimiento, ya que estas no eran modificadas durante el programa.
2024-09-20 prueba_funcional_pushbutton
    se agrega prueba funcional pushbutton para probar correcto funcionamiento de los pulsadores, con antirebote.
    [Boton de panico - Heltek - Schematic.pdsprj]
2024-09-20 debounce
    * Se agrega control de rebotes para los tres pulsadores.
    * Se corrige la falla que enviaba dos veces lora.
    [Hardware.h, Hardware.ino, Panic_Button.ino]
2024-09-20 update 1.7.2
    * Se cambia secuencia de leds: al presionar boton led1/2/3 -> se recibe respuesta led_recibido -> se recibe respuesta atendido led_atendido -> luego de cierto tiempo se apagan todos los leds.
    * Pendiente, ver cuestion: que pasa con las tareas cuando se recibe lora y sms a la vez.
    Pendiente configurar led encendido en GPIO23con ADC en GPIO13.
    * Pendiente mejorar Tasks en setup.
2024-09-24 Update 1.8
    * Se crea config_task(); para organizar mejor el setup de task.
    * Se saca t5, t6 y t7 del loop para ser habilitados en las interrupciones
2024-09-24 update 1.8
    * Se agrega Remitente2 mastermonitor
    * Se actualiza los recibidos por lora
    */
    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
2024-09-24 Update Boton de panico - Heltek - Schematic.pdsprj
    Se corrige divisor resistivo para el ADC IN que estaba mal ubicada una resistencia. También se corrige PCB.
    [Boton de panico - Heltek - Schematic.pdsprj]
2024-09-24 update 1.8
    * V1.8
    * * Se crea config_task(); para organizar mejor el setup de task.
    * * Se saca t5, t6 y t7 del loop para ser habilitados en las interrupciones.
    * * Se agrega Remitente2 mastermonitor
    * * Se actualiza los recibidos por lora
    * * Se agrega lectura ADC al taskManager. Boton powerON funcional.
    * * Se corrige divisor resistivo en lectura ADC, tanto en esquemático, placa prototipo y PCB.
    [Hardware.h, Hardware.ino, Panic_Button.ino, Task.h, Task.ino]
2024-09-25 update
    se sacan variables que no se usan
2024-10-01 updates
    * Se mejora buttontask1, 2 y 3.
    * Se saca la parte de lora del loop0 y se la pasa al loop principal para probar estabilidad.
2024-10-01 lock and unlock
    * Bloqueo de pulsadores por 5 segundos para evitar que presionen muchas veces en poco tiempo.
    Se crea la tarea lock que llama a la funcion unlock.
2024-10-01 Update 1.8.1
    * V1.8.1
    * * Bloqueo de pulsadores por 10 segundos para evitar que presionen muchas veces en poco tiempo. Se crea tarea lock para bloquear que llama luego a la funcion unlock para desbloquear.
    * * Se agrega funcion config_inicial en el setup para definir el estado de los leds cuando arranca el dispositivo.
    * * Se cambian tipos de variables para los statebutton, se saca volatile bool y se deja solamente bool.
2024-10-04 mensaje_recibido.indexOf("OK")
    //comparo si recibo OK en el string de mensaje_recibido funcional
2024-10-07 update 1.8.2
    * V1.8.2:
    * Se agregan nuevos mensajes recibidos: "informadorcv" y "cerradorcv". cerradorcv sin función aun.
    * Ahora rcv_informado apaga todos los leds luego de 15 segundos de recibir el mensaje. A futuro se aumentara este tiempo.
2024-10-14 update blinkstb
    * Se reduce a 3 segundos el tiempo del blinkstb.
2024-10-14 random number
    //Prueba generar numero aleatorio de 8 digitos para usarlos de idempotencia
2024-10-14 update 1.8.3
    * Se crea función idempotencia_random para generar un numero aleatorio de 8 digitos para ser usado de idempotencia en los mensajes.
    * Ahora el mensaje saliente es: "mensaje, idempotencia". Ejemplo: "policia, 61283763" ; "Lpolicia, 61283763" (para lora).
2024-10-14 Update Task.ino
    se completa los mensajes de bomberos y medica con dato de idempotencia
2024-10-15 Update Prueba_randomNUM_Lora.ino
    //Se prueba la función toInt(), para convertir un string en int.
2024-10-15 update led_powerON
    ledOnTime 200
    ledOffTime 2000
    digitalWrite(led_powerON, HIGH);
2024-10-15 update VERSION
    * * Se crea prueba para generar numeros aleatorios para usarlo de idempotencia.
    * * Ahora el mensaje saliente es: "mensaje, idempotencia". Ejemplo: "policia, 61283763" ; "Lpolicia, 61283763" (para lora).
    * * Mensajes de entrada son similares a los salientes: "mensaje, idempotencia". Ejemplo: "policiarcv, 61283763" ; "Lpoliciarcv, 61283763" (para lora).
    * * Update led_powerON = HIGH (al iniciar), ledOnTime = 200, ledOffTime = 2000.
2024-10-15 extraer_numero
    //funcion para extraer el numero de un mensaje del tipo String: "mensaje, numero"
    +
    cambios menores
2024-10-16 update 1.8.4
    * Se crean dos funciones extraer_numero en Hardware.ino, para obtener el número de idempotencia recibido. Una función es para mensajes lora del tipo char[] y la otra para SMS.
    * Se agrega if (SIM800L.available()) antes de while(SIM800L.available()>0) para hacer el código más seguro y eficiente. Permite asegurar de que solo se leerá los datos cuando realmente haya datos disponibles.
    * Se agrega lock.disable() dentro de config_task para que los botones ya esten habilitados al presionarse por primera vez.
2024-10-17 Update V1.8.4
    * V1.8.4
    * Se agrega bandera checknum para comparar si el número idempotencia es el mismo que el recibido.
    * Se agrega condición de mensaje recibido: numrcv == numsnt y ch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
2024-10-21 update informadorcv_lora
    * Se agrega informadorcv_lora y procesamiento de este mensaje.
2024-10-21 Tinformadorcv_Led.
    * Se agrega secuencia de luces cuando se recibe informadorcv, con la tarea Tinformadorcv_Led.
2024-10-22 update 1.8.5
    * * Se agrega secuencia de luces cuando se recibe informadorcv, con la tarea Tinformadorcv_Led.
    * * Se modifican algunos delays en el setup.
    * * Se agrega la condicion numrcv == numsnt en atendido e informado.
    * * Se agrega ESP.restart() cuando se recibe el mensaje ERROR, debido a que a veces inicia mal el SIM800 y debe resetearse el micro para establecer la correcta comunicación.
    [Hardware.ino, Panic_Button.ino]
2024-10-25 Update Boton de panico - Heltek - Schematic.pdsprj
    Se agrega bat sense al esquemático en proteus, pendiente modificación PCB.
    [Boton de panico - Heltek - Schematic.pdsprj]
2025-01-30 Update Boton de panico - Heltek - Schematic.pdsprj
    update plano de tierra top cupper PCB
    [Boton de panico - Heltek - Schematic.pdsprj]
2025-01-31 add prueba lora interrupt
2025-01-31 update
    lora interrupt
2025-02-03 update lora interrupt
    se termina de corregir lora interrupt cambiando tipo de variable para bandera. bool -> byte
2025-02-19 Update 1.8.6
    * V1.8.6:
    * Se agrega lora como interrupcion, para priorizar mensajes recibidos.
    * Se agrega deep_sleep mode.
    * Los botones despierta del deep_sleep y envia el mensaje correspondiente.
    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
2025-03-14 Create Prueba_WifiAPyWebServer.ino
    Se agrega prueba wifiAP + webServer
    Para incorporarlo en el proyecto como siguiente versión
2025-03-31 Sleep mode sim800
    * V1.8.7
    * * Se agrega modo sleep para el sim800.
    * * Se agregan las funciones dormirSIM800 y despertarSIM800
2025-04-01 update
    test cambio de tiempos para evitar fallas que provocaban reinicios del micro
2025-04-29 update branch
    * * Se hacen modificaciones con respecto a como se administra la interrupción de lora.
    * * Se cambia de lugar el lora.update() porque habia un BUG que mostraba el mensaje anterior recibido debido a que el buffer no se actualizaba en el tiempo correcto.
    * * Se retira todo el código viejo que correspondia al uso de 2 cores.
    [Hardware.h, Hardware.ino, LoraTec.h, LoraTec.ino, Panic_Button.ino, Prueba_lora_interrupt.ino, Task.h]
2025-04-30 error con DTR Pin
    Se encuentra una falla con el pin DTR debe ser cambiado. GPIO21 presenta fallas.
    [Hardware.ino, LoraTec.ino, Panic_Button.ino, Task.h, pinout.h]
2026-05-07 fix pdr
    se corrige pdr, antes no esperaba el tiempo que decia para reintentos.
    Se agrega pdr como una tarea mas.
    [Hardware.ino, Panic_Button.ino, Task.h, Task.ino]
2026-05-07 mayor fixes
    1. Se crea carpeta docs para documentar codigo por secciones.
    2. Se agrega en configuracion.h para forzar el SF a funcionar solo en uno, para ensayos.
    3. se refactoriza la funcion sendpackage para que espere el ack correctamente
    [Hardware.ino, LoraTec.h, LoraTec.ino, configuracion.h]
2026-05-07 fix lora
    Se arregla problema de que no se recibian mensajes lora, se achican los mensajes de la trama.
    Se agregan algunos debug.
    [Hardware.h, Hardware.ino, Panic_Button.ino, configuracion.h]
2026-05-07 Limpieza comentarios
    Se limpian comentarios que no se usaban.
2026-05-07 Update configuracion.h
    Empezamos versión 1.8.8, donde incluirá la función para ensayos.
2026-05-07 vers 1.8.8 ENSAYOS
    Se arma función de ensayos para enviar de forma periódica mensajes sms y lora.
    Se crea documentación de ensayos.
2026-05-11 Cierre 1.8.8
    /* Detalle de versiones
    * V1.8.8:
    * PDR con TaskScheduler y ACK async; recepcion LoRa sin readData en ISR; poll RX de respaldo.
    * Parser numeros tolerante; tokens LoRa compactos (Lp/Lpr/Lar/Lir); modo ensayo SMS+LoRa.
    * SF test opcional (FORCE_FIXED_SF_TEST); documentacion en docs/.
    * Helpers de RX/depuracion en LoraTec (isValidLoraPayload, loraRxDebug*); pragma once en configuracion.h.
    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
2026-05-12 update ensayos lora+sms
    Se agrega la posibilidad de enviar ensayos tanto lora como sms, configurando ENSAYO_INCLUIR_SMS en configuracion.h.
2026-06-18 Vers1.8.9
    Envía primero Lora luego SMS ya que es mas rápido.
    Se cambia Software serial por hardware serial ya que el esp32 tiene UART2.
    Se agrega la configuración de DTR para usar el modo sleep del sim800.
2026-08-27 sms
    se mejora recepcion de sms para que el sim800 no se reinicie
2026-08-27 V2.0: RX Class C fijo SF7/500; PDR en SF7 y SF de ensayo despues
    Beelan ataba Datarate_Rx al SF de uplink (TX+0x0A), asi que con SF10
    el nodo escuchaba SF10/500 y no veia la bajada LoraTec (SF7/500).
    LORATEC_RX_FIXED_SF7 en Config.h deja el RX en DR13; el TX sigue el
    SF de prueba. La PDR de arranque usa DEFAULT_SF para el ACK; botones
    y ensayo aplican FORCE_FIXED_SF_TEST despues.
    SMS linea a linea, destino fijo, ISR solo banderas, heap sin String
    y serial reducido a TX/RX y errores. DEBUG_GSM ya no come el UART
    del parser SMS.
    [Hardware.h, Hardware.ino, LoraTec.h, LoraTec.ino, Panic_Button.ino, Task.h, Task.ino, configuracion.h]
